Chillkroetchen/Plant_Watering_Public/README.md

# Plant_Watering
For use:
    1. configure variables in userConfig_sample.h
    2. rename userConfig_sample.h to userConfig.h
    3. build and upload to ESP32
