Chillkroetchen/Plant_Watering_Public/(list of files, drawings)

Other design files:
PCB_Layout.fzz
