Chillkroetchen/Plant_Watering_Public/PCB/PCB_V1.3/PCB_Layout_MOSFET.kicad_pcb

## KiCad design PCB/PCB_V1.3/PCB_Layout_MOSFET.kicad_pcb (2025-01-11, an earlier design)

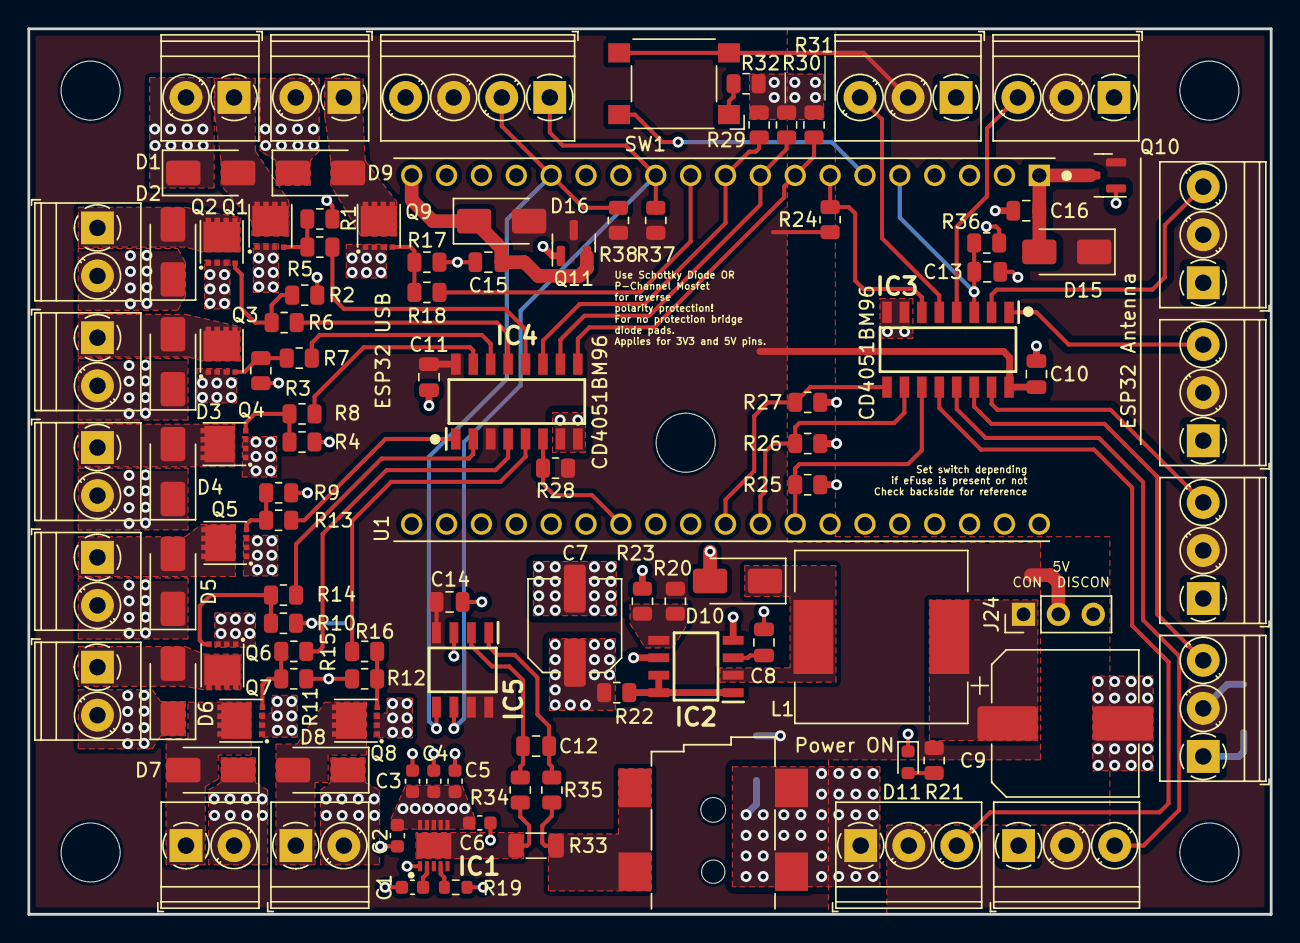
[picture p1: board PCB_Layout_MOSFET.kicad_pcb from above]

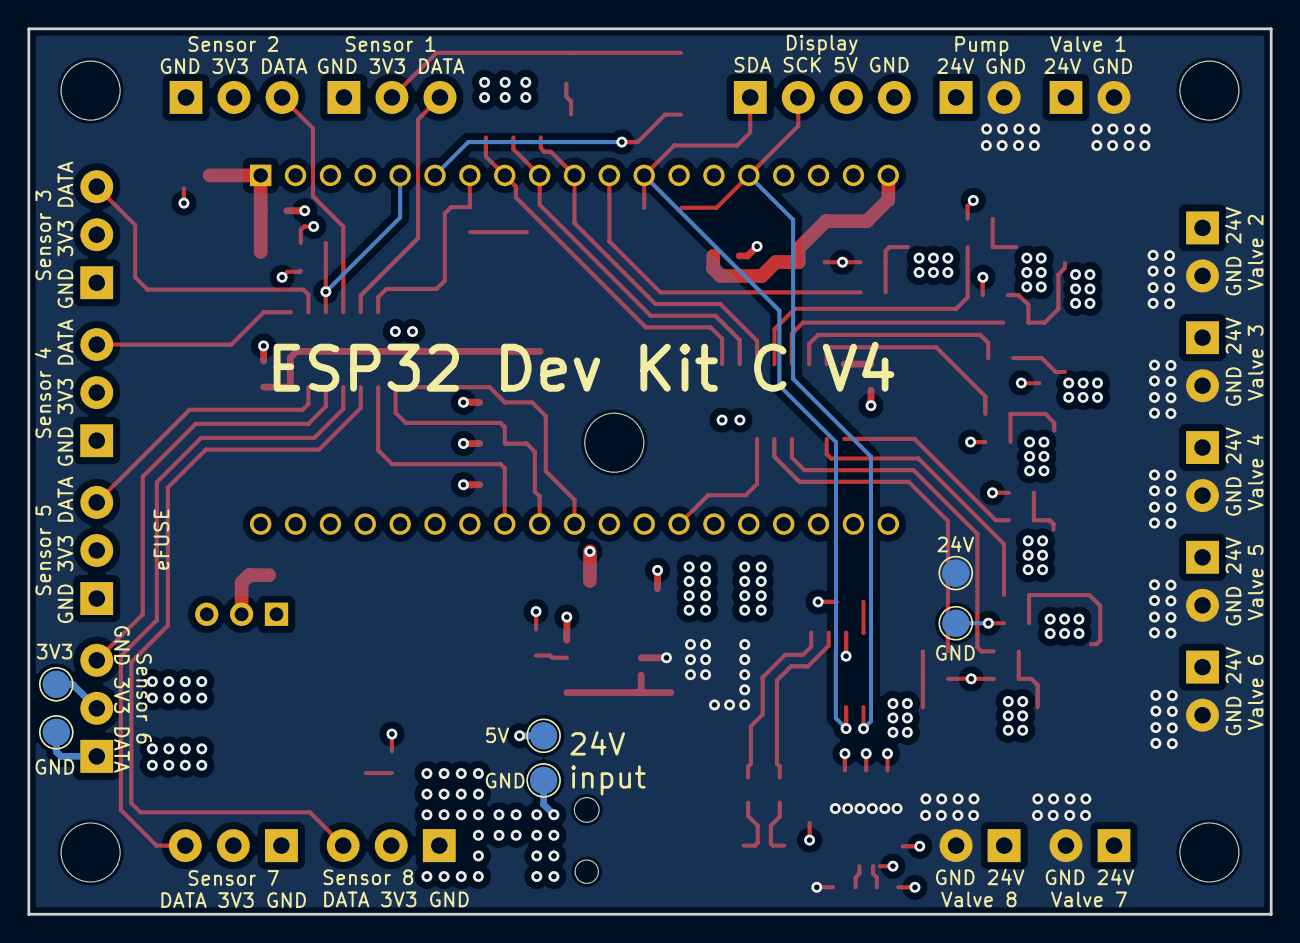
[picture p2: board PCB_Layout_MOSFET.kicad_pcb from below]

Board: 4 copper layers, 90.5 x 64.5 mm, 117 parts (6 on the bottom side), 66 nets.

Parts:
C1: 470pF; C_0603_1608Metric
C2, C3, C4, C5, C6: 100nF; C_0603_1608Metric
C7: 100uF; CP_Elec_6.3x7.7
C8: 470pF; C_0805_2012Metric
C9: 470uF; CP_Elec_10x10.5
C10, C11, C12, C13, C14, C15, C16: 100nF; C_0805_2012Metric
D1, D2, D3, D4, D5, D6, D7, D8, D9, D10, D15, D16: 1N5819; D_SMA
D11: LED Blue; LED_0603_1608Metric
H1, H2, H3, H4, H5: MountingHole; MountingHole_4.3mm_M4
IC1: NIS4461MT3TXG; SON50P300X300X80-11N
IC2: MC34063ADR2G; SOIC127P600X175-8N
IC3, IC4: CD4051BM96; SOIC127P600X175-16N
IC5: INA219AIDR; SOIC127P600X175-8N
J1, J2, J3, J4, J5, J6, J7, J8, J9: Screw_Terminal_01x02; TerminalBlock_Phoenix_PT-1,5-2-3.5-H_1x02_P3.50mm_Horizontal
J10: KH-DC-050-2.0STM; CUI_PJ-002BH-SMT-TR
J11, J12, J13, J14, J15, J16, J17, J18: Screw_Terminal_01x03; TerminalBlock_Phoenix_PT-1,5-3-3.5-H_1x03_P3.50mm_Horizontal
J19: Screw_Terminal_01x04; TerminalBlock_Phoenix_PT-1,5-4-3.5-H_1x04_P3.50mm_Horizontal
J24: Conn_01x03; PinHeader_1x03_P2.54mm_Vertical
L1: 220uH; L_12x12mm_H8mm_3D
Q1, Q2, Q3, Q4, Q5, Q6, Q7, Q8, Q9: TPN2R805PL,L1Q; TPN2R805PLL1Q
Q10, Q11: SE3415; SOT-23
R1, R2, R3, R4, R9, R10, R11, R12, R17, R20, R37, R38: 3.6k; R_0805_2012Metric
R5, R6, R7, R8, R13, R14, R15, R16, R18: 330; R_0805_2012Metric
R19: 20; R_0603_1608Metric
R21, R23: 1.2k; R_0805_2012Metric
R22: 0.33; R_0805_2012Metric
R24, R25, R26, R27, R28, R29, R30, R31, R32, R36: 1M; R_0805_2012Metric
R33: R_Shunt_20m; R_1206_3216Metric
R34, R35: 0; R_0805_2012Metric
SW1: SW_MEC_5E; SW_SPST_Omron_B3FS-100xP_3D
TP1, TP2, TP3, TP4, TP5, TP6: TestPoint; TestPoint_Pad_D2.0mm
U1: ESP32-DEVKITC-32D; MODULE_ESP32-DEVKITC-32D

Connections:
3V3: D15.1 (K), J11.2, J12.2, J13.2, J14.2, J15.2, J16.2, J17.2, J18.2, Q10.2 (S), SW1.3 (K), SW1.4 (A), TP4.1
5V: C10.1, C11.1, C14.1, D16.2 (A), IC3.16 (VDD), IC4.3 (Z), IC4.16 (VDD), IC5.4 (VS), IC5.7 (A0), IC5.8 (A1), J19.3, J24.2, Q11.3 (D), R20.2, R21.2, R24.1, R28.1, R37.1, R38.1, TP1.1
5V_raw: C9.1, J24.1, L1.1
24V: C2.1, C3.1, C4.1, C5.1, C6.1, C7.1, D1.1 (K), D2.1 (K), D3.1 (K), D4.1 (K), D5.1 (K), D6.1 (K), D7.1 (K), D8.1 (K), D9.1 (K), IC1.6 (SRC_1), IC1.7 (SRC_2), IC1.8 (SRC_3), IC1.9 (SRC_4), IC1.10 (SRC_5), IC2.6 (VCC), J1.2, J2.2, J3.2, J4.2, J5.2, J6.2, J7.2, J8.2, J9.2, R19.1, R22.1, TP3.1
24V_raw: J10.1A, J10.1B, R33.1, R33.2, R35.2
24V_sensed: IC1.11 (EP), R33.3, R33.4, R34.2
/EXT_3V3: C16.1, D15.2 (A), Q10.3 (D), U1.1 (3V3)
/EXT_5V: C15.1, D16.1 (K), Q11.2 (S), U1.19 (EXT_5V)
/High Power Externals/Q1_drain: D1.2 (A), J1.1, Q1.5 (D_1), Q1.6 (D_2), Q1.7 (D_3), Q1.8 (D_4), Q1.9 (D_5)
/High Power Externals/Q1_gate: Q1.4 (G), R1.1, R5.1
/High Power Externals/Q2_drain: D2.2 (A), J2.1, Q2.5 (D_1), Q2.6 (D_2), Q2.7 (D_3), Q2.8 (D_4), Q2.9 (D_5)
/High Power Externals/Q2_gate: Q2.4 (G), R2.1, R6.1
/High Power Externals/Q3_drain: D3.2 (A), J3.1, Q3.5 (D_1), Q3.6 (D_2), Q3.7 (D_3), Q3.8 (D_4), Q3.9 (D_5)
/High Power Externals/Q3_gate: Q3.4 (G), R3.1, R7.1
/High Power Externals/Q4_drain: D4.2 (A), J4.1, Q4.5 (D_1), Q4.6 (D_2), Q4.7 (D_3), Q4.8 (D_4), Q4.9 (D_5)
/High Power Externals/Q4_gate: Q4.4 (G), R4.1, R8.1
/High Power Externals/Q5_drain: D5.2 (A), J5.1, Q5.5 (D_1), Q5.6 (D_2), Q5.7 (D_3), Q5.8 (D_4), Q5.9 (D_5)
/High Power Externals/Q5_gate: Q5.4 (G), R9.1, R13.1
/High Power Externals/Q6_drain: D6.2 (A), J6.1, Q6.5 (D_1), Q6.6 (D_2), Q6.7 (D_3), Q6.8 (D_4), Q6.9 (D_5)
/High Power Externals/Q6_gate: Q6.4 (G), R10.1, R14.1
/High Power Externals/Q7_drain: D7.2 (A), J7.1, Q7.5 (D_1), Q7.6 (D_2), Q7.7 (D_3), Q7.8 (D_4), Q7.9 (D_5)
/High Power Externals/Q7_gate: Q7.4 (G), R11.1, R15.1
/High Power Externals/Q8_drain: D8.2 (A), J8.1, Q8.5 (D_1), Q8.6 (D_2), Q8.7 (D_3), Q8.8 (D_4), Q8.9 (D_5)
/High Power Externals/Q8_gate: Q8.4 (G), R12.1, R16.1
/High Power Externals/Q9_drain: D9.2 (A), J9.1, Q9.5 (D_1), Q9.6 (D_2), Q9.7 (D_3), Q9.8 (D_4), Q9.9 (D_5)
/High Power Externals/Q9_gate: Q9.4 (G), R17.1, R18.1
/Power Supply/CII: IC2.5 (CII), R20.1, R23.2
/Power Supply/I Lim: IC1.4 (ILIM), R19.2
/Power Supply/LED: D11.2 (A), R21.1
/Power Supply/SWC: IC2.1 (SWC), IC2.7 (IPK), IC2.8 (DRC), R22.2
/Power Supply/SWE: D10.1 (K), IC2.2 (SWE), L1.2
/Power Supply/TC: C8.1, IC2.3 (TC)
/Power Supply/dV/dT: C1.1, IC1.2 (DV/DT)
Button: SW1.2, U1.6 (IO35)
GND: C1.2, C2.2, C3.2, C4.2, C5.2, C6.2, C7.2, C8.2, C9.2, C10.2, C11.2, C13.2, C14.2, C15.2, C16.2, D10.2 (A), D11.1 (K), IC1.1 (GND), IC2.4 (GND), IC3.7 (VEE), IC3.8 (VSS), IC4.7 (VEE), IC4.8 (VSS), IC5.3 (GND), J10.2, J10.3, J11.1, J12.1, J13.1, J14.1, J15.1, J16.1, J17.1, J18.1, J19.4, Q1.1 (S_1), Q1.2 (S_2), Q1.3 (S_3), Q2.1 (S_1), Q2.2 (S_2), Q2.3 (S_3), Q3.1 (S_1), Q3.2 (S_2), Q3.3 (S_3), Q4.1 (S_1), Q4.2 (S_2), Q4.3 (S_3), Q5.1 (S_1), Q5.2 (S_2), Q5.3 (S_3), Q6.1 (S_1), Q6.2 (S_2), Q6.3 (S_3), Q7.1 (S_1), Q7.2 (S_2), Q7.3 (S_3), Q8.1 (S_1), Q8.2 (S_2), Q8.3 (S_3), Q9.1 (S_1), Q9.2 (S_2), Q9.3 (S_3), Q10.1 (G), Q11.1 (G), R1.2, R2.2, R3.2, R4.2, R9.2, R10.2, R11.2, R12.2, R17.2, R23.1, R25.1, R26.1, R27.1, R29.1, R30.1, R31.1, R32.2, R36.1, TP2.1, TP5.1, TP6.1, U1.14 (GND1), U1.20 (GND3), U1.26 (GND2)
unnamed: C12.1, IC5.1 (IN+), R35.1
unnamed: C12.2, IC5.2 (IN-), R34.1
unnamed: R32.1, SW1.1
Pump_Gate: R18.2, U1.11 (IO27)
SCL: IC5.5 (SCL), J19.2, R38.2, U1.15 (IO13)
SDA: IC5.6 (SDA), J19.1, R37.2, U1.12 (IO14)
Sensors_Enable: IC3.6 (~E), R24.2, U1.7 (IO32)
Sensors_Select1: IC3.11 (S1), R25.2, U1.27 (IO19)
Sensors_Select2: IC3.10 (S2), R26.2, U1.28 (IO18)
Sensors_Select3: IC3.9 (S3), R27.2, U1.29 (IO5)
Sensors_Signal: C13.1, IC3.3 (Z), R36.2, U1.5 (IO34)
Valves_Enable: IC4.6 (~E), R28.2, U1.32 (IO4)
Valves_Select1: IC4.11 (S1), R29.2, U1.10 (IO26)
Valves_Select2: IC4.10 (S2), R30.2, U1.9 (IO25)
Valves_Select3: IC4.9 (S3), R31.2, U1.8 (IO33)
Y0: IC4.13 (Y0), R6.2
Y0.2: IC3.13 (Y0), J17.3
Y1: IC4.14 (Y1), R7.2
Y1.2: IC3.14 (Y1), J16.3
Y2: IC4.15 (Y2), R8.2
Y2.2: IC3.15 (Y2), J15.3
Y3: IC4.12 (Y3), R5.2
Y3.2: IC3.12 (Y3), J18.3
Y4: IC4.1 (Y4), R13.2
Y4.2: IC3.1 (Y4), J14.3
Y5: IC4.5 (Y5), R16.2
Y5.2: IC3.5 (Y5), J11.3
Y6: IC4.2 (Y6), R14.2
Y6.2: IC3.2 (Y6), J13.3
Y7: IC4.4 (Y7), R15.2
Y7.2: IC3.4 (Y7), J12.3
