Chillkroetchen/Plant_Watering_Public/PCB/Test_PCBs/DC-DC-Converter/DC-DC-Converter.kicad_pcb

## KiCad design PCB/Test_PCBs/DC-DC-Converter/DC-DC-Converter.kicad_pcb (2023-01-16)

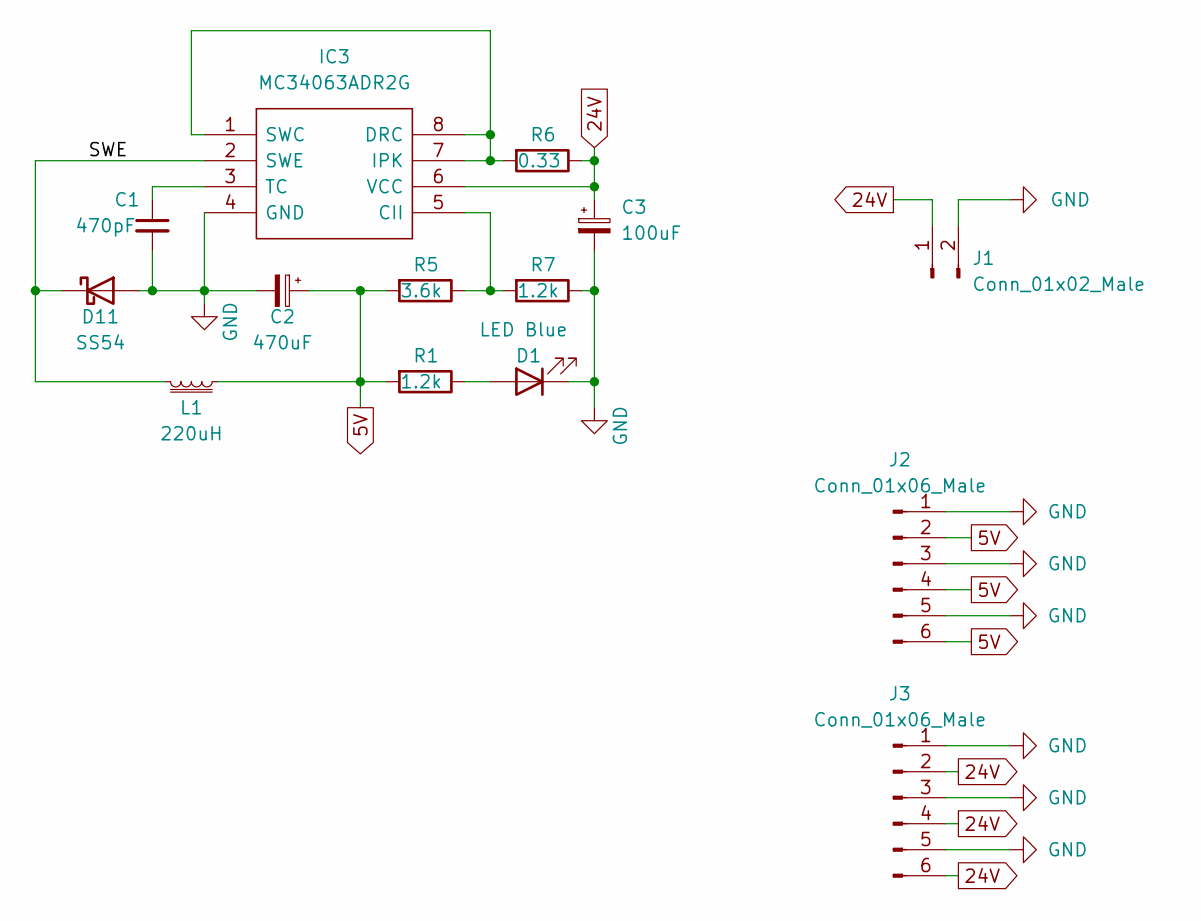
[picture p3: schematic DC-DC-Converter.kicad_sch, Plant Watering]

Parts:
C1: 470pF; C_0805_2012Metric; LCSC C1743
C2: 470uF; CP_Elec_10x10.5; LCSC C129479
C3: 100uF; CP_Elec_6.3x7.7; LCSC C3001220
D1: LED Blue; LED_0603_1608Metric; LCSC C72041
D11: SS54; D_SMA; LCSC C22452
IC3: MC34063ADR2G; SOIC127P600X175-8N; LCSC C32078
J1: Conn_01x02_Male; PinHeader_1x02_P2.54mm_Vertical
J2, J3: Conn_01x06_Male; PinHeader_2x03_P2.54mm_Vertical
L1: 220uH; L_1210_3225Metric; LCSC C394104
R1, R7: 1.2k; R_0805_2012Metric; LCSC C17379
R5: 3.6k; R_0805_2012Metric; LCSC C18359
R6: 0.33; R_0805_2012Metric; LCSC C491232

Connections:
5V: C2.1, J2.2, J2.4, J2.6, L1.1, R1.2, R5.2
24V: C3.1, IC3.6 (VCC), J1.1, J3.2, J3.4, J3.6, R6.1
/SWE: D11.1 (K), IC3.2 (SWE), L1.2
GND: C1.2, C2.2, C3.2, D1.1 (K), D11.2 (A), IC3.4 (GND), J1.2, J2.1, J2.3, J2.5, J3.1, J3.3, J3.5, R7.1
unnamed: C1.1, IC3.3 (TC)
unnamed: D1.2 (A), R1.1
unnamed: IC3.1 (SWC), IC3.7 (IPK), IC3.8 (DRC), R6.2
unnamed: IC3.5 (CII), R5.1, R7.2

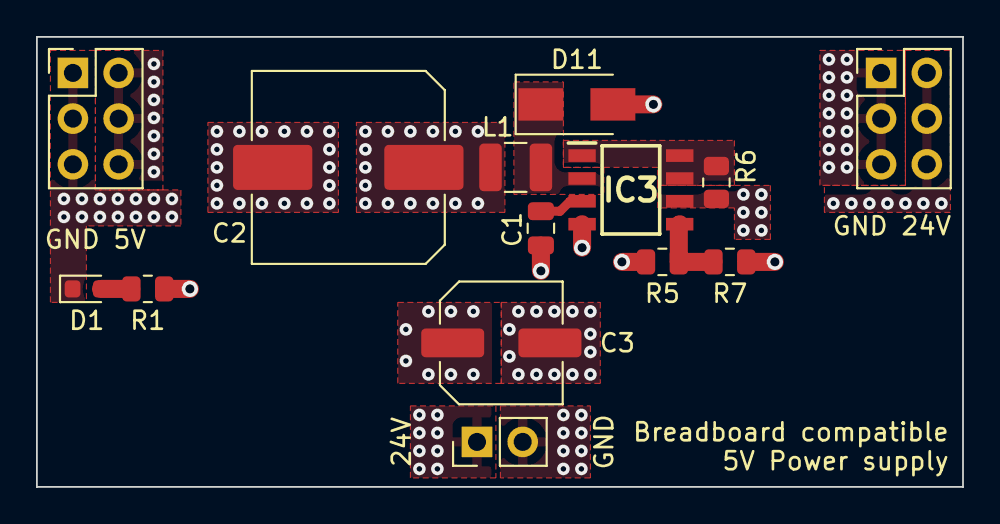
[picture p4: board DC-DC-Converter.kicad_pcb from above]

Board: 4 copper layers, 51.5 x 25.0 mm, 14 parts (0 on the bottom side), 8 nets.
