Chillkroetchen/Plant_Watering_Public/PCB/Test_PCBs/Multiplex_MOSFET/Multiplex_MOSFET.kicad_pcb

## KiCad design PCB/Test_PCBs/Multiplex_MOSFET/Multiplex_MOSFET.kicad_pcb (2023-01-16)

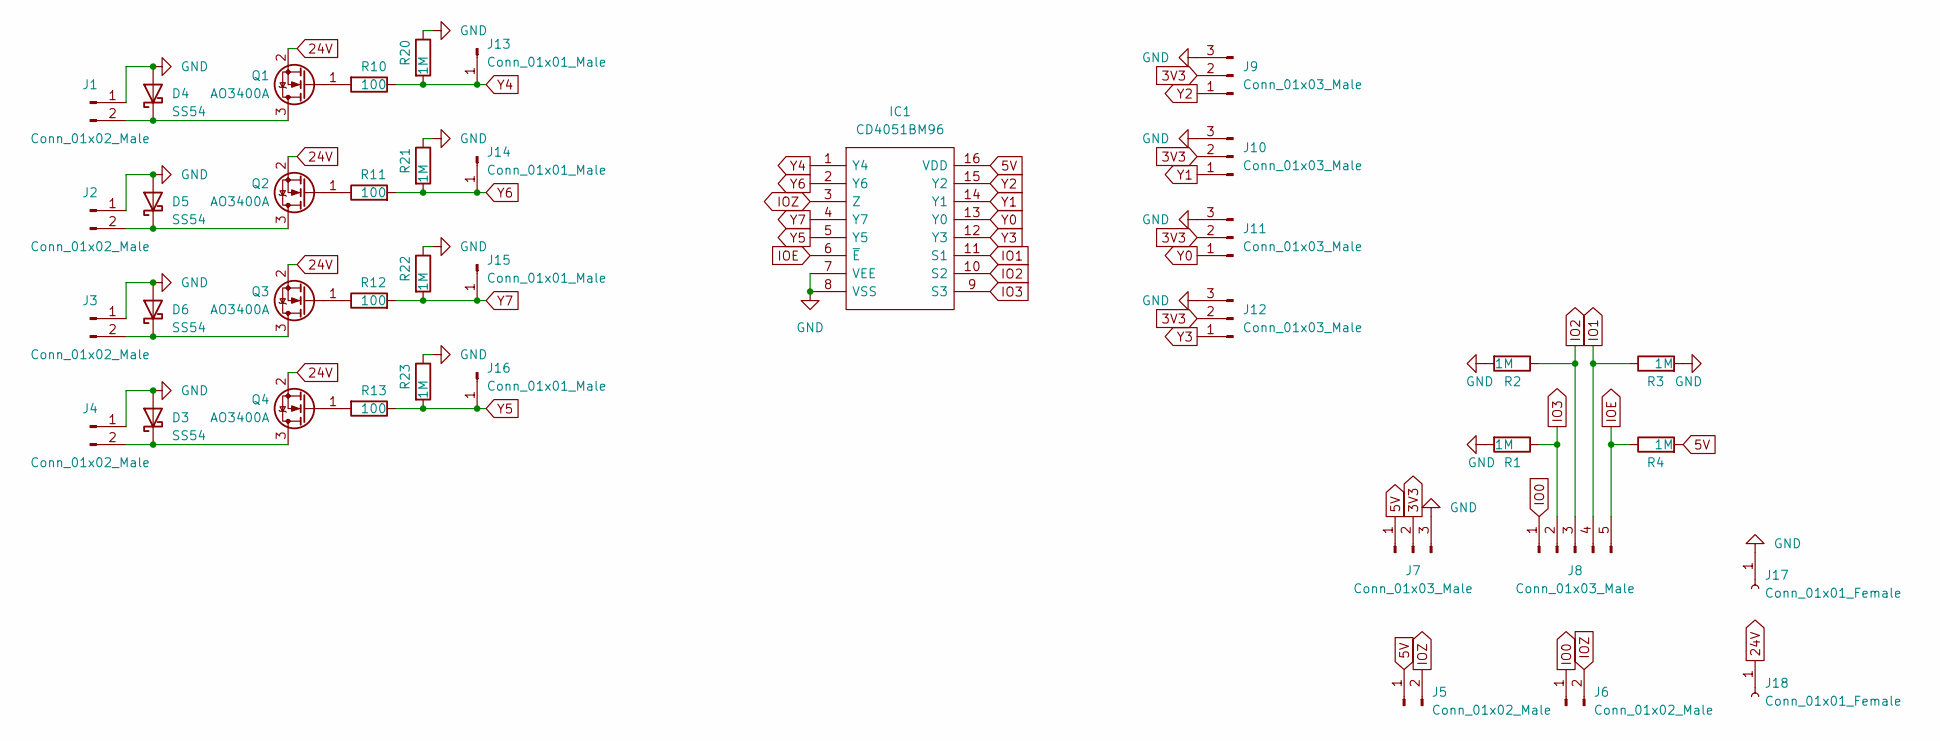
[picture p5: schematic Multiplex_MOSFET.kicad_sch, Plant Watering]

Parts:
D3, D4, D5, D6: SS54; D_SMA; LCSC C22452
IC1: CD4051BM96; SOIC127P600X175-16N; Manufacturer_Part_Number CD4051BM96; LCSC C21379
J1, J2, J3, J4, J5, J6: Conn_01x02_Male; PinHeader_1x02_P2.54mm_Vertical
J7, J9, J10, J11, J12: Conn_01x03_Male; PinHeader_1x03_P2.54mm_Vertical
J8: Conn_01x03_Male; PinHeader_1x05_P2.54mm_Vertical
J13, J14, J15, J16: Conn_01x01_Male; PinHeader_1x01_P2.54mm_Vertical
J17, J18: Conn_01x01_Female; MountingHole_2.2mm_M2_ISO14580_Pad
Q1, Q2, Q3, Q4: AO3400A; SOT-23; LCSC C20917
R1, R2, R3, R4, R20, R21, R22, R23: 1M; R_0805_2012Metric; LCSC C17514
R10, R11, R12, R13: 100; R_0805_2012Metric; LCSC C17408

Connections:
3V3: J7.2, J9.2, J10.2, J11.2, J12.2
5V: IC1.16 (VDD), J5.1, J7.1, R4.2
24V: J18.1, Q1.2 (S), Q2.2 (S), Q3.2 (S), Q4.2 (S)
GND: D3.2 (A), D4.2 (A), D5.2 (A), D6.2 (A), IC1.7 (VEE), IC1.8 (VSS), J1.1, J2.1, J3.1, J4.1, J7.3, J9.3, J10.3, J11.3, J12.3, J17.1, R1.2, R2.2, R3.2, R20.1, R21.1, R22.1, R23.1
IO0: J6.1, J8.1
IO1: IC1.11 (S1), J8.4, R3.1
IO2: IC1.10 (S2), J8.3, R2.1
IO3: IC1.9 (S3), J8.2, R1.1
IOE: IC1.6 (~E), J8.5, R4.1
IOZ: IC1.3 (Z), J5.2, J6.2
unnamed: D3.1 (K), J4.2, Q4.3 (D)
unnamed: D4.1 (K), J1.2, Q1.3 (D)
unnamed: D5.1 (K), J2.2, Q2.3 (D)
unnamed: D6.1 (K), J3.2, Q3.3 (D)
unnamed: Q1.1 (G), R10.2
unnamed: Q2.1 (G), R11.1
unnamed: Q3.1 (G), R12.1
unnamed: Q4.1 (G), R13.2
Y0: IC1.13 (Y0), J11.1
Y1: IC1.14 (Y1), J10.1
Y2: IC1.15 (Y2), J9.1
Y3: IC1.12 (Y3), J12.1
Y4: IC1.1 (Y4), J13.1, R10.1, R20.2
Y5: IC1.5 (Y5), J16.1, R13.1, R23.2
Y6: IC1.2 (Y6), J14.1, R11.2, R21.2
Y7: IC1.4 (Y7), J15.1, R12.2, R22.2

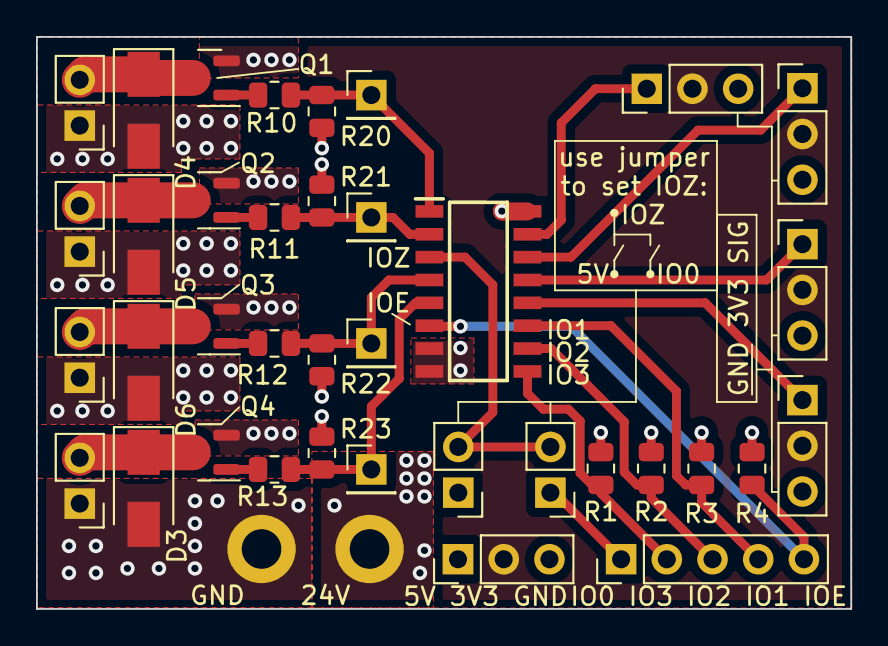
[picture p6: board Multiplex_MOSFET.kicad_pcb from above]

Board: 4 copper layers, 45.2 x 31.8 mm, 39 parts (0 on the bottom side), 26 nets.
