Chillkroetchen/Plant_Watering_Public/(commit log)

2023-01-16 Remove private info
    [BOM_PCB_Layout_MOSFET.csv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]
2025-01-11 PCB: added power sensor
    [Calculations_AIO.xlsx, MOSFET_Power.xlsx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]
2025-01-11 feat: added library for INA260 power sensor
